Vanrykel/Multi-purpose-robot/README.md

# Multi-purpose robot
 A shapeoko 2 equipped with a beckhoff PLC, vision and speach.
