Vanrykel/Multi-purpose-robot/Solution CAD/STL/Magneet_As.stl

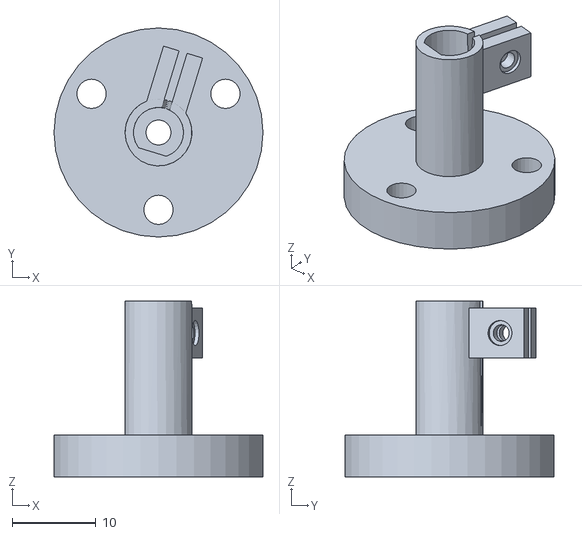
[picture p16: CAD file, 2020-01-24]
Solution CAD/STL/Magneet_As.stl
25.0 x 25.0 x 21.0
