Vanrykel/Multi-purpose-robot/Solution CAD/STL/DremelMount.stl

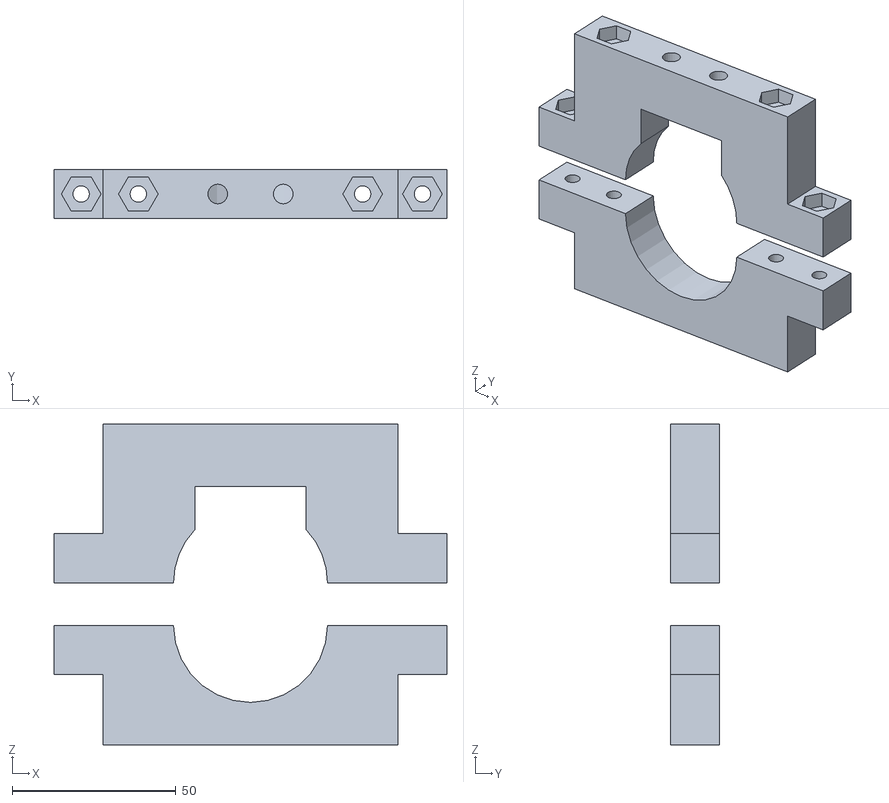
[picture p17: CAD file, 2020-01-24]
Solution CAD/STL/DremelMount.stl
120.0 x 15.0 x 98.0
