Vanrykel/Multi-purpose-robot/Solution CAD/STL/zuignap_as2.stl

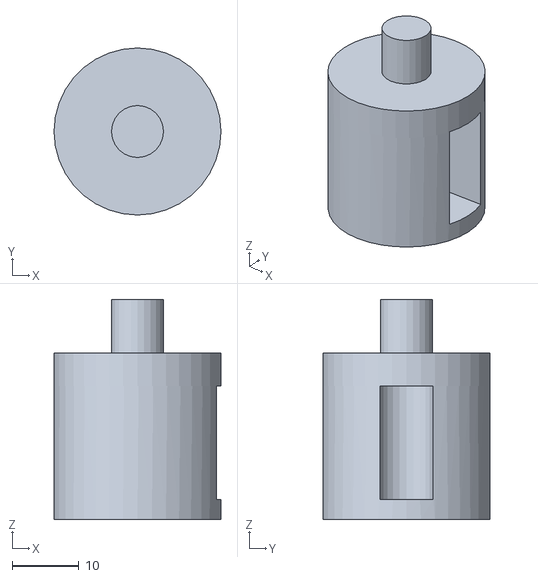
[picture p18: CAD file, 2020-01-24]
Solution CAD/STL/zuignap_as2.stl
25.0 x 25.0 x 33.0
