Vanrykel/Multi-purpose-robot/Solution CAD/STL/Zuignap_As.stl

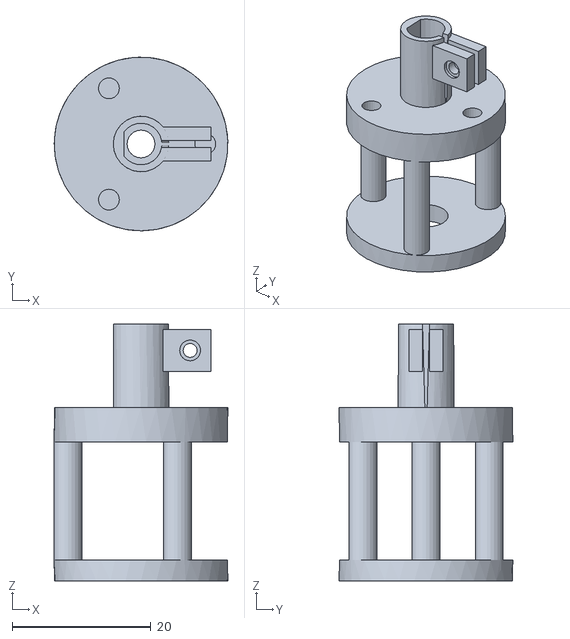
[picture p19: CAD file, 2020-01-24]
Solution CAD/STL/Zuignap_As.stl
25.0 x 25.0 x 37.0
