Vanrykel/Multi-purpose-robot/Solution CAD/STL/PenConnect.stl

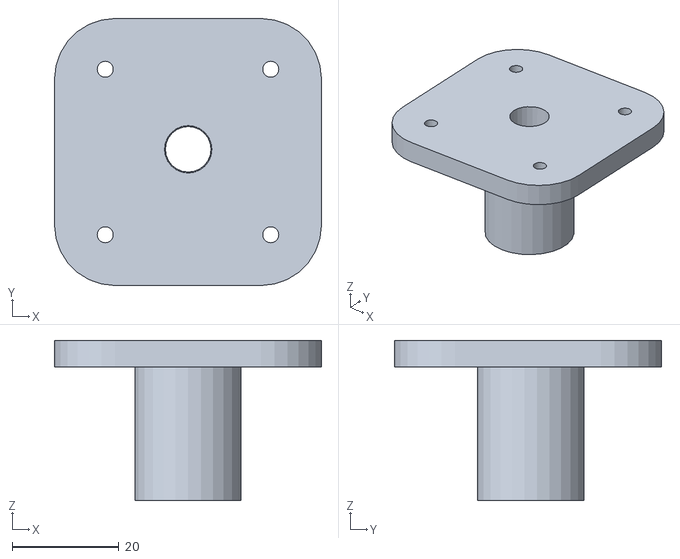
[picture p20: CAD file, 2020-01-24]
Solution CAD/STL/PenConnect.stl
50.0 x 50.0 x 30.0
