Vanrykel/Multi-purpose-robot/Solution CAD/STL/servo_mount.stl

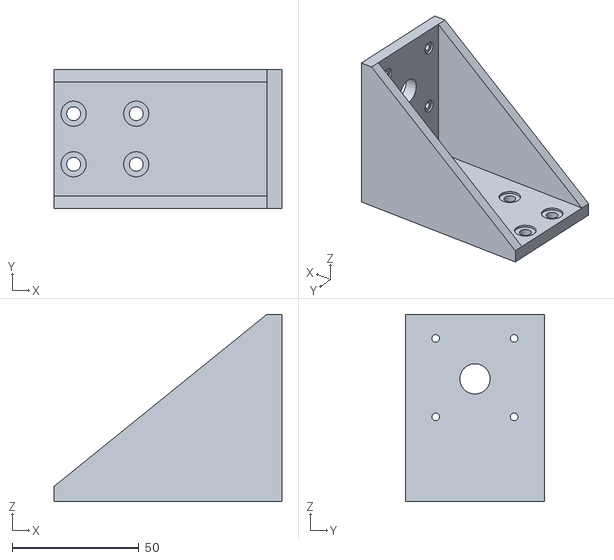
[picture p21: CAD file, 2020-01-24]
Solution CAD/STL/servo_mount.stl
90.1 x 55.0 x 74.0
