Vanrykel/Multi-purpose-robot/Solution CAD/STL/magneet_as2.stl

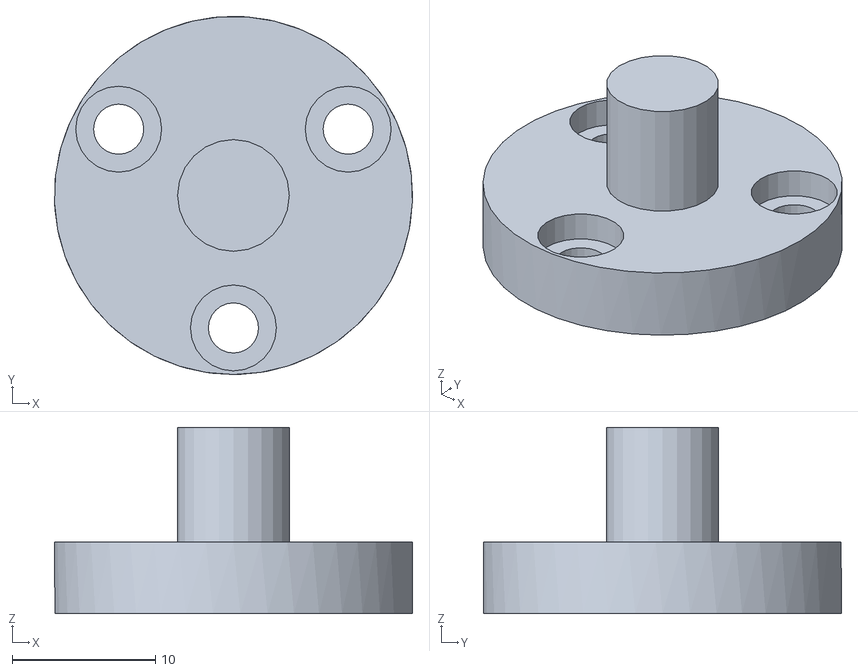
[picture p22: CAD file, 2020-01-24]
Solution CAD/STL/magneet_as2.stl
25.0 x 25.0 x 13.0
