Vanrykel/Multi-purpose-robot/(list of files, cad)

Other CAD files:
Solution CAD/FullConcept.dwg
Solution CAD/zuignap.dwg
Solution CAD/servo_connecction.dwg
Solution CAD/Magneet.dwg
Solution CAD/DremelMount.dwg
Solution CAD/Magneet_As.dwg
Solution CAD/PenConnect.dwg
Solution CAD/Zuignap_As.dwg
Solution CAD/magneet_as2.dwg
Solution CAD/servo_mount.dwg
Solution CAD/zuignap_as2.dwg
