Vanrykel/Multi-purpose-robot/(commit log)

2019-11-21 Big initial update
    Big initial update of the different components TwinCAT, Rasberry Pi, Snips and CAD files of heads.
    [DremelMount.dwg, DremelMount.stl, FullConcept.dwg, Magneet.dwg, Magneet_As.dwg, Magneet_As.stl, Zuignap_As.dwg, Zuignap_As.stl]
2020-01-24 Puting it all together
    Puting it all things together with communication between all parts.
    [DremelMount.dwg, DremelMount.stl, Magneet_As.dwg, Magneet_As.stl, PenConnect.dwg, PenConnect.stl, Zuignap_As.dwg, Zuignap_As.stl]
